Karcious/FPGA-Inverted-Pendulum/fpga/src/control/swing_once.v

`timescale 1ns/1ps
module swing_once(
    input wire clk, rst_n, tick, request, balance_safe, sensor_valid, gains_valid,
    input wire [15:0] theta, center, hang,
    input wire [11:0] raw_angle,
    input wire sensor_fresh,
    input wire signed [31:0] position,
    input wire signed [15:0] delta,
    input wire signed [31:0] pulse_duty,
    input wire [31:0] pulse_ms, timeout_ms, travel_max,
    input wire [31:0] switch_deg, switch_dps,
    input wire signed [31:0] step_target, step_kp, step_kd,
    input wire [31:0] capture_ms,

    input wire signed [31:0] brake_gain,

    input wire signed [31:0] settle_gain,

    input wire mode_handoff,
    output reg [3:0] fault_code,
    output reg entered, confirmed, gap_seen, gap_active,
    output wire signed [15:0] telemetry_pos,
    output wire balance,
    output reg signed [15:0] drive,
    output reg [2:0] state
);
    localparam IDLE=0, REST=1, POSITION=2, WAIT_UP=3, BALANCE=4, FAULT=5, CAPTURE=6;

    localparam [1:0]  RETRY_MAX  = 2'd3;
    localparam [7:0]  RETRY_STEP = 8'd20;
    localparam signed [31:0] SWING_TARGET_MAX = 32'sd400;
    reg  [1:0] retry_count;
    wire retryable = (fault_code==4'd3) ||
                     (fault_code==4'd5) ||
                     (fault_code==4'd7) ||
                     (fault_code==4'd8) || (fault_code==4'd9) ||
                     (fault_code==4'd10);

    localparam [2:0]  REST_MAX   = 3'd6;
    reg  [2:0] rest_count;

    reg  [1:0] swing_idx;

    wire [7:0] retry_bump_u = {6'd0, swing_idx} * RETRY_STEP;
    wire signed [31:0] swing_raw = step_target + $signed({24'd0, retry_bump_u});

    wire signed [31:0] swing_target = swing_raw > SWING_TARGET_MAX ?
                                      SWING_TARGET_MAX : swing_raw;
    reg [5:0] gap_age;
    reg [9:0] capture_age;
    reg [11:0] previous_raw;
    wire pre_capture = state==POSITION || state==WAIT_UP;
    wire near_edge = raw_angle<64 || raw_angle>4028;
    wire edge_wrap = (previous_raw<256 && raw_angle>3836) ||
                     (previous_raw>3836 && raw_angle<256);
    wire edge_approach = previous_raw<128 || previous_raw>3964;

    wire gap_allowed = pre_capture && sensor_fresh &&
                       (gap_active || (near_edge && edge_approach) || edge_wrap);

    localparam [15:0] RAW_STEP_MAX = 16'd160;
    wire [15:0] raw_step = raw_angle>previous_raw ? raw_angle-previous_raw
                                                  : previous_raw-raw_angle;
    wire raw_trusted = (raw_step<=RAW_STEP_MAX) || edge_wrap || !sensor_valid;
    reg [15:0] elapsed;
    reg [7:0] stable;
    reg signed [31:0] origin;
    reg [15:0] history [0:19];
    reg [4:0] history_idx;
    reg [5:0] valid_count;
    reg [15:0] previous;
    integer k;
    wire signed [16:0] velocity = $signed({1'b0,theta}) - $signed({1'b0,history[history_idx]});
    wire [16:0] velocity_abs = velocity[16] ? -velocity : velocity;
    wire signed [32:0] travel = {position[31],position}-{origin[31],origin};
    wire [15:0] dp_abs = delta[15] ? -delta : delta;
    wire [15:0] angle_abs = theta>center ? theta-center : center-theta;
    wire [15:0] hang_abs = theta>hang ? theta-hang : hang-theta;
    wire [15:0] jump = theta>previous ? theta-previous : previous-theta;

    localparam [2:0] JUMP_DEBOUNCE = 3'd4;
    reg  [2:0] jump_bad;
    wire jump_glitch = state!=REST && state!=FAULT && !gap_allowed &&
                       valid_count!=0 && jump>1024;
    wire jump_dead = (jump_bad==JUMP_DEBOUNCE-1'b1);

    reg [15:0] capture_angle, capture_velocity;
    always @(posedge clk or negedge rst_n) begin
        if(!rst_n) begin capture_angle<=0; capture_velocity<=0; end
        else begin
            case(switch_deg)
                32'd5: capture_angle<=16'd57;
                32'd6: capture_angle<=16'd69;
                32'd7: capture_angle<=16'd80;
                32'd8: capture_angle<=16'd92;
                32'd9: capture_angle<=16'd103;
                32'd10: capture_angle<=16'd115;
                32'd11: capture_angle<=16'd126;
                32'd12: capture_angle<=16'd138;
                32'd13: capture_angle<=16'd150;
                32'd14: capture_angle<=16'd161;
                32'd15: capture_angle<=16'd173;
                32'd16: capture_angle<=16'd184;
                32'd17: capture_angle<=16'd196;
                32'd18: capture_angle<=16'd207;
                32'd19: capture_angle<=16'd219;
                32'd20: capture_angle<=16'd230;
                32'd21: capture_angle<=16'd242;
                32'd22: capture_angle<=16'd253;
                32'd23: capture_angle<=16'd265;
                32'd24: capture_angle<=16'd277;
                32'd25: capture_angle<=16'd288;
                32'd26: capture_angle<=16'd300;
                32'd27: capture_angle<=16'd311;
                32'd28: capture_angle<=16'd323;
                32'd29: capture_angle<=16'd334;
                32'd30: capture_angle<=16'd346;
                default: capture_angle<=0;
            endcase
            case(switch_dps)
                32'd10, 32'd11, 32'd12: capture_velocity<=16'd2;
                32'd13, 32'd14, 32'd15, 32'd16, 32'd17: capture_velocity<=16'd3;
                32'd18, 32'd19, 32'd20, 32'd21: capture_velocity<=16'd4;
                32'd22, 32'd23, 32'd24, 32'd25: capture_velocity<=16'd5;
                32'd26, 32'd27, 32'd28, 32'd29, 32'd30: capture_velocity<=16'd6;
                32'd31, 32'd32, 32'd33, 32'd34: capture_velocity<=16'd7;
                32'd35, 32'd36, 32'd37, 32'd38: capture_velocity<=16'd8;
                32'd39, 32'd40, 32'd41, 32'd42, 32'd43: capture_velocity<=16'd9;
                32'd44, 32'd45, 32'd46, 32'd47: capture_velocity<=16'd10;
                32'd48, 32'd49, 32'd50, 32'd51: capture_velocity<=16'd11;
                32'd52, 32'd53, 32'd54, 32'd55, 32'd56: capture_velocity<=16'd12;
                32'd57, 32'd58, 32'd59, 32'd60: capture_velocity<=16'd13;
                32'd61, 32'd62, 32'd63, 32'd64: capture_velocity<=16'd14;
                32'd65, 32'd66, 32'd67, 32'd68, 32'd69: capture_velocity<=16'd15;
                32'd70, 32'd71, 32'd72, 32'd73: capture_velocity<=16'd16;
                32'd74, 32'd75, 32'd76, 32'd77: capture_velocity<=16'd17;
                32'd78, 32'd79, 32'd80, 32'd81, 32'd82: capture_velocity<=16'd18;
                32'd83, 32'd84, 32'd85, 32'd86: capture_velocity<=16'd19;
                32'd87, 32'd88, 32'd89, 32'd90: capture_velocity<=16'd20;
                32'd91, 32'd92, 32'd93, 32'd94, 32'd95: capture_velocity<=16'd21;
                32'd96, 32'd97, 32'd98, 32'd99: capture_velocity<=16'd22;
                32'd100, 32'd101, 32'd102, 32'd103: capture_velocity<=16'd23;
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
                32'd594, 32'd595, 32'd596, 32'd597: capture_velocity<=16'd137;
                32'd598, 32'd599, 32'd600: capture_velocity<=16'd138;
                default: capture_velocity<=0;
            endcase
        end
    end

    reg signed [32:0] travel_pipe;
    reg [32:0] travel_magnitude;
    reg travel_exceeded;
    always @(posedge clk or negedge rst_n) begin
        if(!rst_n) begin travel_pipe<=0; travel_magnitude<=0; travel_exceeded<=0; end
        else if(!request || state==IDLE) begin
            travel_pipe<=0; travel_magnitude<=0; travel_exceeded<=0;
        end else begin
            travel_pipe<=travel;
            travel_magnitude<=travel_pipe[32] ? -travel_pipe : travel_pipe;
            travel_exceeded<=travel_magnitude>{1'b0,travel_max};
        end
    end
    wire [31:0] step_abs = step_target[31] ? -step_target : step_target;
    wire config_ok = pulse_ms>=20 && pulse_ms<=1000 && timeout_ms>pulse_ms && timeout_ms<=5000 &&
                     travel_max>=60 && travel_max<=520 && switch_deg>=5 && switch_deg<=30 &&
                     switch_dps>=10 && switch_dps<=600 && pulse_duty>=-1024 && pulse_duty<=1024 &&
                     (pulse_duty<=-100 || pulse_duty>=100) && gains_valid &&
                     step_abs>=20 && step_abs<=400 && step_abs+32'd40<=travel_max &&
                     step_kp>0 && step_kp<=32'sd1048576 && step_kd>=0 && step_kd<=32'sd8388608 &&
                     capture_ms>=5 && capture_ms<=100 && hang>=200 && center>hang && center-hang>=1500;
    wire upright_raw = sensor_valid && !gap_active && valid_count==20 && angle_abs<=capture_angle && velocity_abs<=capture_velocity;

    reg upright;
    always @(posedge clk or negedge rst_n) begin
        if(!rst_n) upright<=1'b0;
        else if(!request) upright<=1'b0;
        else upright<=upright_raw;
    end
    wire [15:0] max_drive = pulse_duty[31] ? -pulse_duty[15:0] : pulse_duty[15:0];

    wire signed [16:0] vel_raw  = $signed({1'b0,theta}) - $signed({1'b0,history[history_idx]});
    wire signed [16:0] vel_fold = vel_raw > 17'sd2048  ? vel_raw - 17'sd4096 :
                                  vel_raw < -17'sd2048 ? vel_raw + 17'sd4096 :
                                  vel_raw;

    wire signed [31:0] damp_gain = (state==REST) ? settle_gain : brake_gain;
    reg signed [31:0] damp_gain_r;
    reg signed [48:0] damp_prod_r;
    always @(posedge clk or negedge rst_n) begin
        if(!rst_n) begin damp_gain_r<=32'sd0; damp_prod_r<=49'sd0; end
        else begin
            damp_gain_r<=damp_gain;
            damp_prod_r<=vel_fold * $signed(damp_gain_r);
        end
    end
    wire signed [32:0] damp_shr = damp_prod_r >>> 16;
    wire signed [16:0] damp_lim = $signed({1'b0, max_drive});
    wire signed [15:0] damp = damp_shr >  damp_lim ? $signed({1'b0, max_drive}) :
                              damp_shr < -damp_lim ? -$signed({1'b0, max_drive}) :
                              damp_shr[15:0];
    wire settle_zone = hang_abs <= 16'd1024;
    reg signed [15:0] local_pos;
    reg signed [31:0] actual_q16,target_q16,limit_q16;
    reg [2:0] pid_div;
    reg step_tick;
    reg [7:0] ready_pipe;
    reg drive_ready;
    wire signed [31:0] position_pid;
    wire step_clear = !request || state!=POSITION;
    always @(posedge clk or negedge rst_n) begin
        if(!rst_n) begin
            local_pos<=0;actual_q16<=0;target_q16<=0;limit_q16<=0;
            pid_div<=0;step_tick<=0;ready_pipe<=0;drive_ready<=0;
        end else begin
            local_pos<=travel_pipe>1024 ? 16'sd1024 : travel_pipe< -1024 ? -16'sd1024 : travel_pipe[15:0];
            actual_q16<={local_pos,16'd0};

            target_q16<={swing_target[15:0],16'd0};
            limit_q16<={max_drive,16'd0};
            step_tick<=0;
            if(step_clear) begin pid_div<=0;ready_pipe<=0;drive_ready<=0;end
            else begin
                if(tick) begin
                    if(pid_div==4) begin pid_div<=0;step_tick<=1;end
                    else pid_div<=pid_div+1'b1;
                end
                ready_pipe<={ready_pipe[6:0],step_tick};
                if(ready_pipe[7]) drive_ready<=1;
            end
        end
    end

    pid_q16 u_position_pid(.clk(clk),.rst_n(rst_n),.en(step_tick),.clear(step_clear),
        .target(target_q16),.actual(actual_q16),.kp(step_kp),.ki(32'sd0),.kd(step_kd),
        .out_max(limit_q16),.out_min(-limit_q16),
        .en_dlpf(1'b0),.en_dspan2(1'b0),

        .en_dspan4(1'b0),.lpf_shift(2'd0),
        .out(position_pid));
    assign balance = request && (state==BALANCE || state==CAPTURE);
    assign telemetry_pos = travel_pipe>8191 ? 16'sd8191 :
                           travel_pipe< -8191 ? -16'sd8191 : travel_pipe[15:0];
    always @(*) begin
        drive=0;
        if(request && state==POSITION && drive_ready && config_ok && sensor_valid && !gap_allowed &&
           !travel_exceeded && dp_abs<=3)

            drive=-$signed(position_pid[31:16]);
        else if(request && state==WAIT_UP && config_ok && sensor_valid && !gap_allowed &&
                !travel_exceeded && dp_abs<=3)

            drive=damp;
        else if(request && state==REST && config_ok && sensor_valid && !gap_allowed &&
                !travel_exceeded && dp_abs<=3 && valid_count==20 && settle_zone)

            drive=damp;
    end

    always @(posedge clk or negedge rst_n) begin
        if(!rst_n) begin
            state<=IDLE;elapsed<=0;stable<=0;origin<=0;history_idx<=0;valid_count<=0;previous<=0;
            fault_code<=0;entered<=0;confirmed<=0;gap_seen<=0;gap_active<=0;
            gap_age<=0;capture_age<=0;previous_raw<=0;retry_count<=2'd0;rest_count<=3'd0;
            swing_idx<=2'd0;
            jump_bad<=3'd0;
            for(k=0;k<20;k=k+1) history[k]<=0;
        end else if(!request) begin
            state<=IDLE;elapsed<=0;stable<=0;valid_count<=0;history_idx<=0;fault_code<=0;
            entered<=0;confirmed<=0;gap_seen<=0;gap_active<=0;gap_age<=0;capture_age<=0;previous_raw<=raw_angle;
            retry_count<=2'd0;rest_count<=3'd0;
            swing_idx<=2'd0;
            jump_bad<=3'd0;
        end else if(tick) begin

            previous<=theta;
            if(raw_trusted) previous_raw<=raw_angle;
            history[history_idx]<=theta;
            history_idx<=history_idx==19 ? 0 : history_idx+1'b1;

            if(jump_glitch) jump_bad<=(jump_bad==JUMP_DEBOUNCE-1'b1)?jump_bad:jump_bad+1'b1;
            else jump_bad<=3'd0;
            if(!sensor_valid || gap_allowed) valid_count<=0;
            else if(valid_count<20) valid_count<=valid_count+1'b1;
            if(state!=IDLE && state!=FAULT && state!=BALANCE) elapsed<=elapsed+1'b1;
            if(state==IDLE) begin
                origin<=position; elapsed<=0; stable<=0; state<=REST;
            end else if(state!=FAULT && ((!sensor_valid && !gap_allowed && state!=REST) ||
                        (jump_dead && !gap_allowed && state!=REST) ||
                        !sensor_fresh || !config_ok || (dp_abs>3 && state!=REST) ||
                        (state!=BALANCE && state!=REST && travel_exceeded))) begin

                state<=FAULT;

                if(!sensor_fresh || (!sensor_valid && !gap_allowed && state!=REST)) fault_code<=1;
                else if(!config_ok) fault_code<=2;
                else if(dp_abs>3) fault_code<=3;
                else if(jump_dead && !gap_allowed && state!=REST) fault_code<=4;
                else fault_code<=5;
            end else if(gap_allowed) begin

                state<=WAIT_UP;stable<=0;gap_seen<=1;
                if(gap_active && gap_age>=49) begin state<=FAULT;fault_code<=9;gap_active<=0;end
                else if(gap_active && sensor_valid && !near_edge && !edge_wrap) begin
                    gap_active<=0;gap_age<=0;
                end else begin gap_active<=1;gap_age<=gap_age+1'b1;end
            end else case(state)
                REST: begin

                    if(mode_handoff && upright) begin
                        state<=CAPTURE;stable<=0;capture_age<=0;entered<=1;
                    end
                    else if(elapsed>=1000) begin
                        if(rest_count<REST_MAX) begin
                            rest_count<=rest_count+1'b1;
                            state<=IDLE;elapsed<=0;stable<=0;
                        end
                        else begin state<=FAULT;fault_code<=6;end
                    end
                    else if(valid_count==20 && hang_abs<=100 && dp_abs<=1 && velocity_abs<=8) begin
                        if(stable==99) begin
                            state<=POSITION;elapsed<=0;stable<=0;

                            origin<=position;
                        end
                        else stable<=stable+1'b1;
                    end else stable<=0;
                end
                POSITION, WAIT_UP: begin
                    if(elapsed+1>=timeout_ms) begin state<=FAULT;fault_code<=7;end
                    else if(upright) begin
                        state<=CAPTURE;stable<=0;capture_age<=0;entered<=1;
                    end else begin
                        stable<=0;
                        if(state==POSITION && elapsed+1>=pulse_ms) begin
                            state<=WAIT_UP;

                            if(swing_idx<2'd3) swing_idx<=swing_idx+1'b1;
                        end
                    end
                end
                CAPTURE: begin
                    capture_age<=capture_age+1'b1;

                    if(balance_safe || angle_abs>700) begin state<=FAULT;fault_code<=8;end
                    else if(capture_age>=499) begin state<=FAULT;fault_code<=10;end
                    else if(upright) begin
                        if({24'd0,stable}+32'd1>=capture_ms) begin
                            state<=BALANCE;confirmed<=1;stable<=0;

                            retry_count<=2'd0;
                            swing_idx<=2'd0;
                        end else stable<=stable+1'b1;
                    end else stable<=0;
                end
                BALANCE: if(balance_safe) begin state<=FAULT;fault_code<=8;end
                FAULT: begin

                    if(retryable && retry_count<RETRY_MAX) begin
                        retry_count<=retry_count+1'b1;
                        state<=IDLE;elapsed<=0;stable<=0;valid_count<=0;history_idx<=0;
                        fault_code<=0;entered<=0;confirmed<=0;gap_seen<=0;gap_active<=0;
                        gap_age<=0;capture_age<=0;

                        if(raw_trusted) previous_raw<=raw_angle;
                        rest_count<=3'd0;jump_bad<=3'd0;
                    end else begin
                        state<=FAULT;gap_active<=0;
                    end
                end
                default: state<=FAULT;
            endcase
        end
    end
endmodule
