Karcious/FPGA-Inverted-Pendulum/(commit log)

2026-11-02 Package REV25 competition project with FPGA, ESP32 and desktop sources
2026-11-02 Add synthesis and routing records with complete build package links
    [device.cfg]
